Breakfast-Eater/Remote-Control-Car/Core/Inc/main.h

#define TIM2_PWMB_Pin GPIO_PIN_0
#define TIM2_PWMB_GPIO_Port GPIOA
#define ESP8266_TX_Pin GPIO_PIN_2
#define ESP8266_TX_GPIO_Port GPIOA
#define ESP8266_RX_Pin GPIO_PIN_3
#define ESP8266_RX_GPIO_Port GPIOA
#define STBY_Pin GPIO_PIN_4
#define STBY_GPIO_Port GPIOA
#define GPIO_EXTI0_Pin GPIO_PIN_0
#define GPIO_EXTI0_GPIO_Port GPIOB
#define GPIO_EXTI0_EXTI_IRQn EXTI0_IRQn
#define GPIO_EXTI1_Pin GPIO_PIN_1
#define GPIO_EXTI1_GPIO_Port GPIOB
#define GPIO_EXTI1_EXTI_IRQn EXTI1_IRQn
#define AIN2_Pin GPIO_PIN_13
#define AIN2_GPIO_Port GPIOB
#define BIN1_Pin GPIO_PIN_14
#define BIN1_GPIO_Port GPIOB
#define BIN2_Pin GPIO_PIN_15
#define BIN2_GPIO_Port GPIOB
#define TIM1_PWMA_Pin GPIO_PIN_8
#define TIM1_PWMA_GPIO_Port GPIOA
#define DEBUG_TX_Pin GPIO_PIN_9
#define DEBUG_TX_GPIO_Port GPIOA
#define DEBUG_RX_Pin GPIO_PIN_10
#define DEBUG_RX_GPIO_Port GPIOA
#define AIN1_Pin GPIO_PIN_15
#define AIN1_GPIO_Port GPIOA
